hotplot/LCMeter/README.md

# LC Meter

This repository contains the schematics, PCB and firmware for a small inductance and capacitance meter I built in 2014

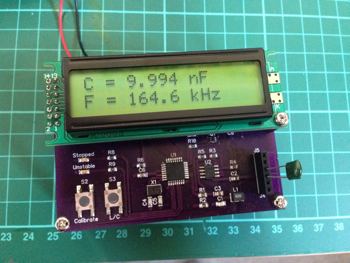
[picture p1: Images/IMG_1926.png]
LC Meter


## Schematics

The schematics can be opened using DipTrace to find part numbers and other details.

### General Schematic

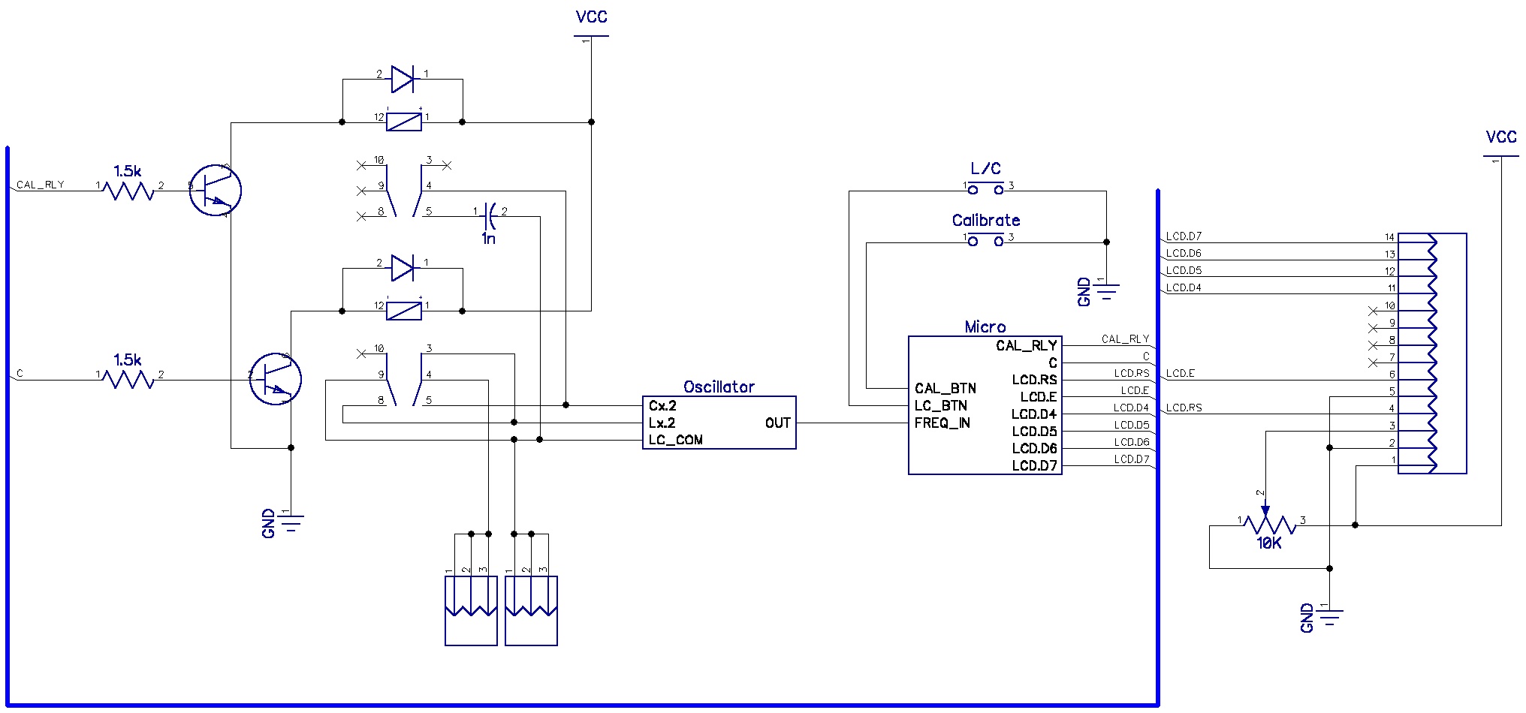
[picture p2: Images/LCMeter.jpg]
General Schematic


### Microcontroller Schematic

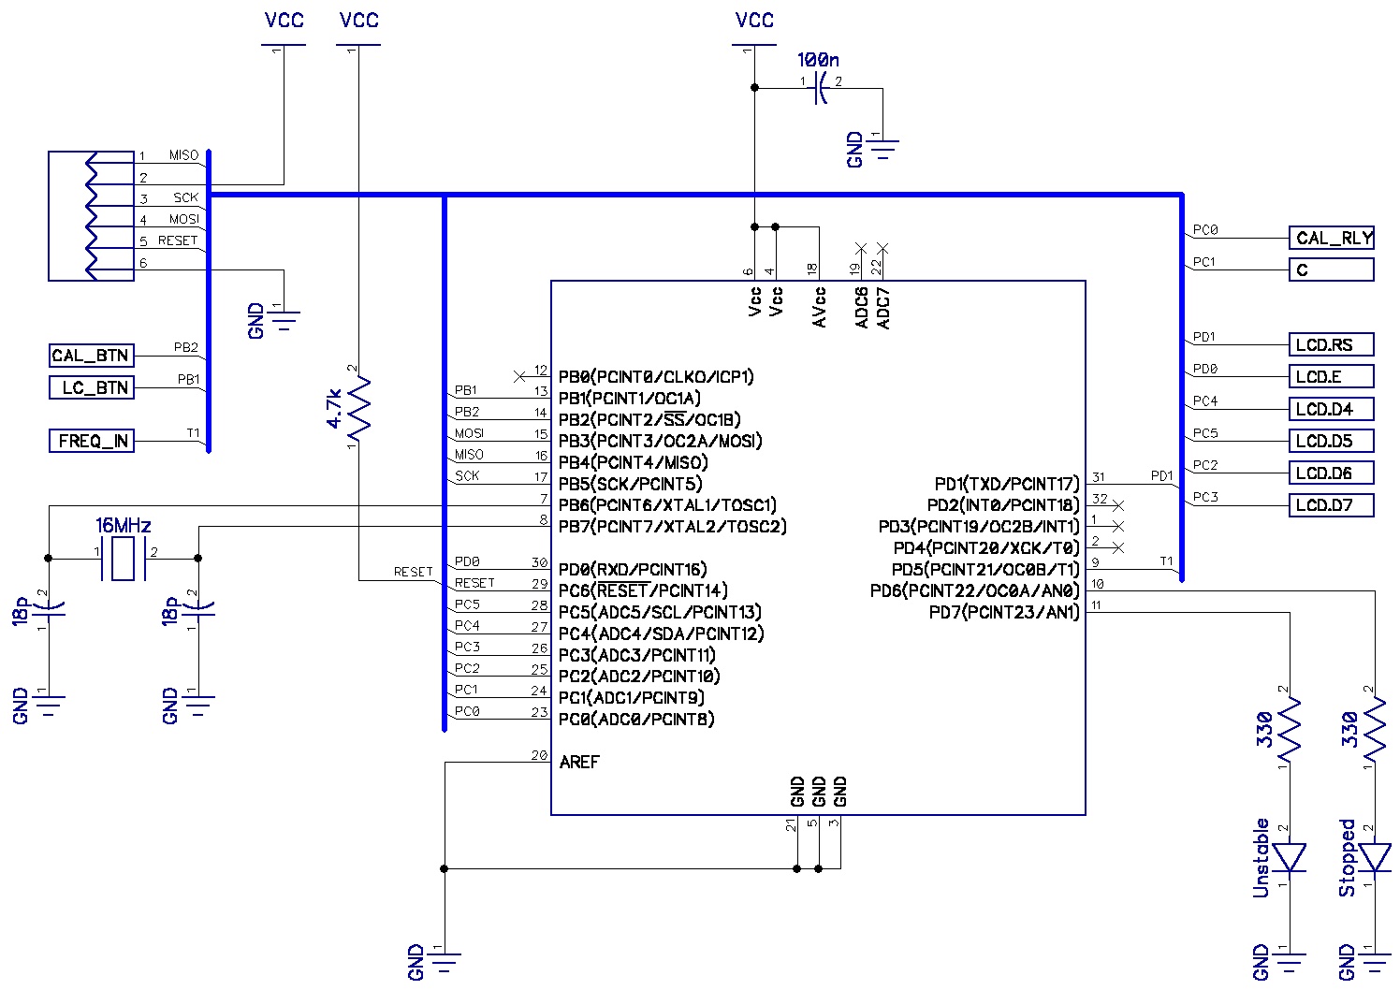
[picture p3: Images/Micro.jpg]
Microcontroller Schematic


### Oscillator Schematic

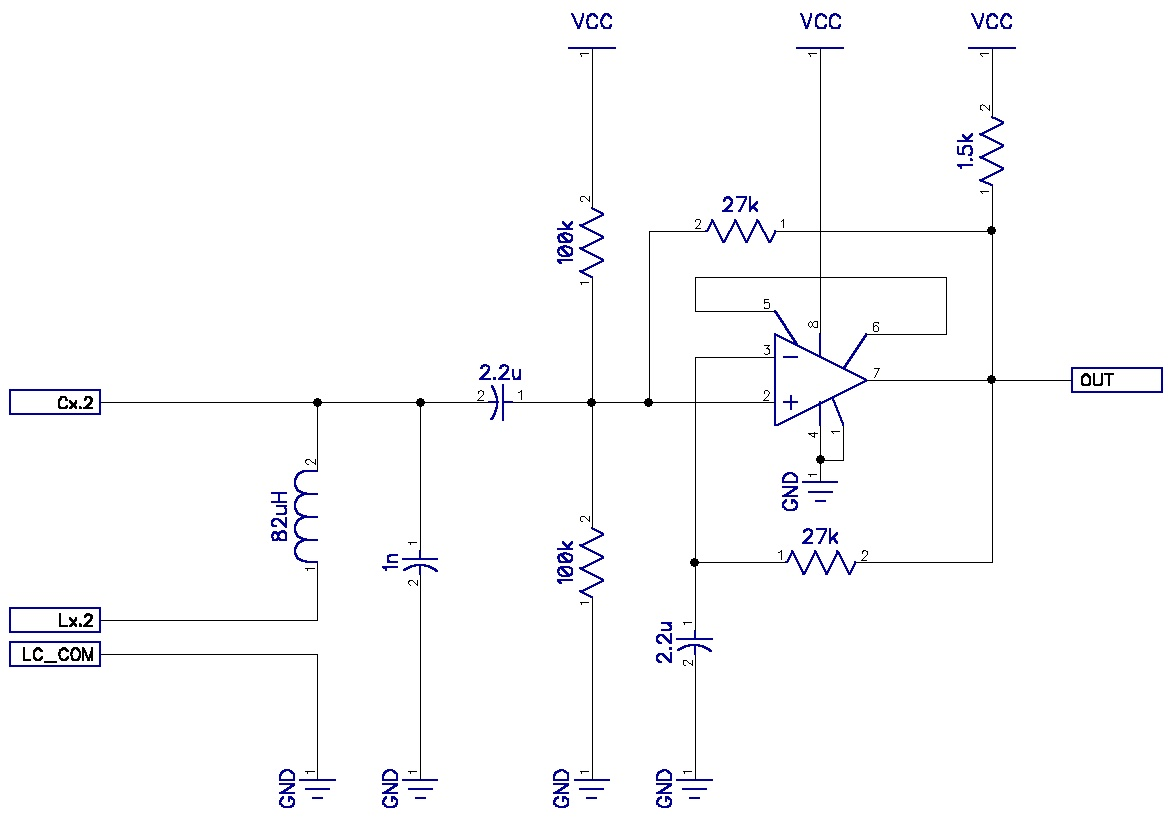
[picture p4: Images/Oscillator.jpg]
Oscillator Schematic


## PCB

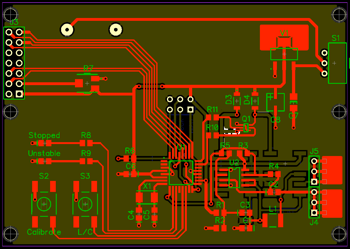
[picture p5: Images/PCBTop.png]

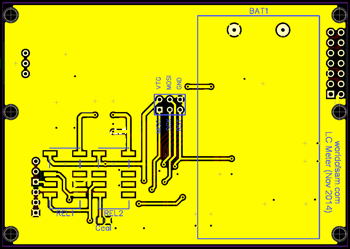
[picture p6: Images/PCBBottom.png]
PCB Bottom


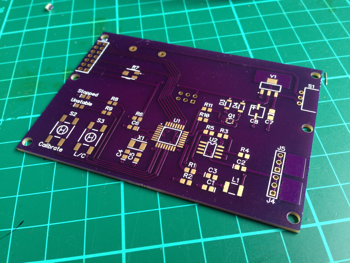
[picture p7: Images/IMG_1912.png]

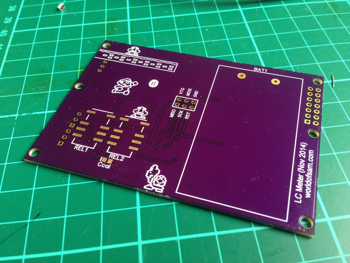
[picture p8: Images/IMG_1913.png]
