hotplot/LCMeter/Images/Power.jpg

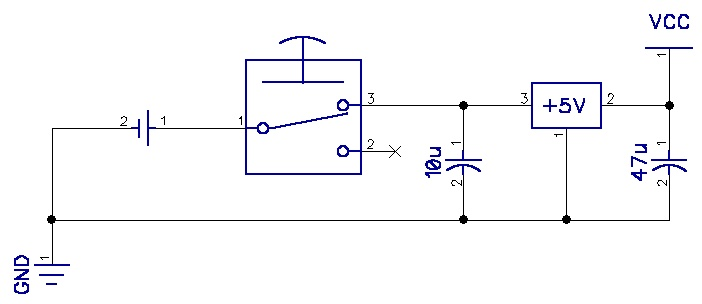
Images/Power.jpg
