hotplot/LCMeter/Spice/Oscillator.asc

C1: cap; 10µ
C2: cap; 10µ
C3: cap; 1n
C4: cap; 10n
L1: ind; 82µ
R1: res; 1000
R2: res; 100K
R3: res; 100K
R4: res; 100K
R5: res; 47K
U2: occomp
V1: voltage; 5
Named nets: 0
.TRAN 1u 3000u 2990u
