hotplot/LCMeter/(list of files, drawings)

Other design files:
Circuit/PCB.dip
Circuit/Schematic.dch
