hotplot/LCMeter/(commit log)

2014-11-20 Initial commit of LC Meter schematics and PCB
    [PCB.dip, Schematic.dch]
2014-11-21 * Replaced 10uF decoupling cap on regulator output with 47uF * Added flyback diodes around relay coils * Relay coils are now driven by BJTs rather than the AVR directly
    [PCB.dip, Schematic.dch]
2014-11-24 * Improved patterns for 47uF cap and relays * Added heatsink to voltage regulator * Increased size of some small traces * Added date and label to silkscreen
    [PCB.dip, Schematic.dch]
2018-09-18 Reorganised project
    [PCB.dip, Schematic.dch]
